VH-Lab/Microdrive-Array/SpikeGadgets_OpenEphys_Drive-main/README.md

# SpikeGadgets_OpenEphys_Drive
A tetrode hyper drive adapted from open ephys to work with spikegadgets
