VH-Lab/Microdrive-Array/Pictures.docx

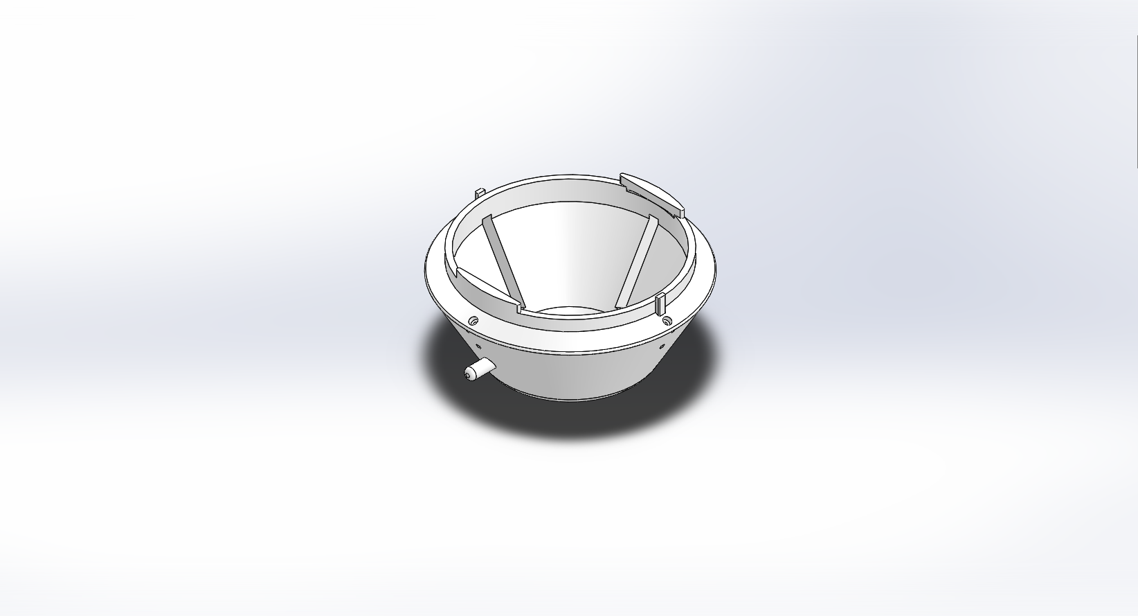
[picture p1: figure]
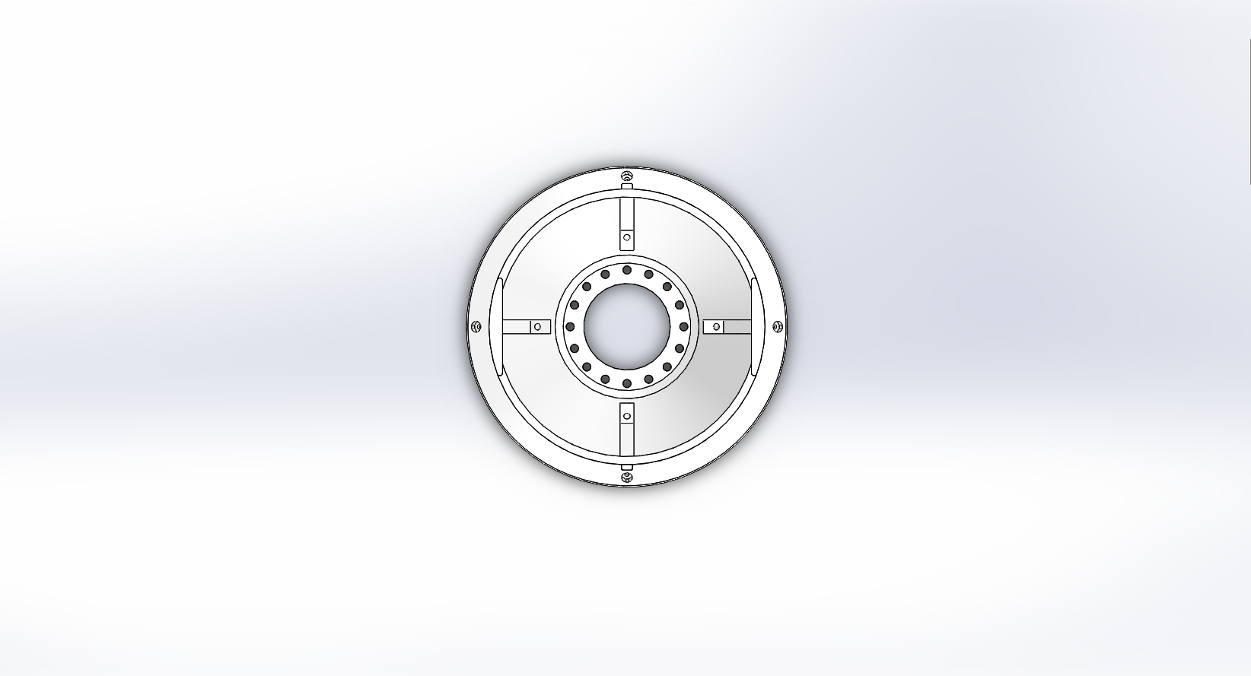
[picture p2: figure]
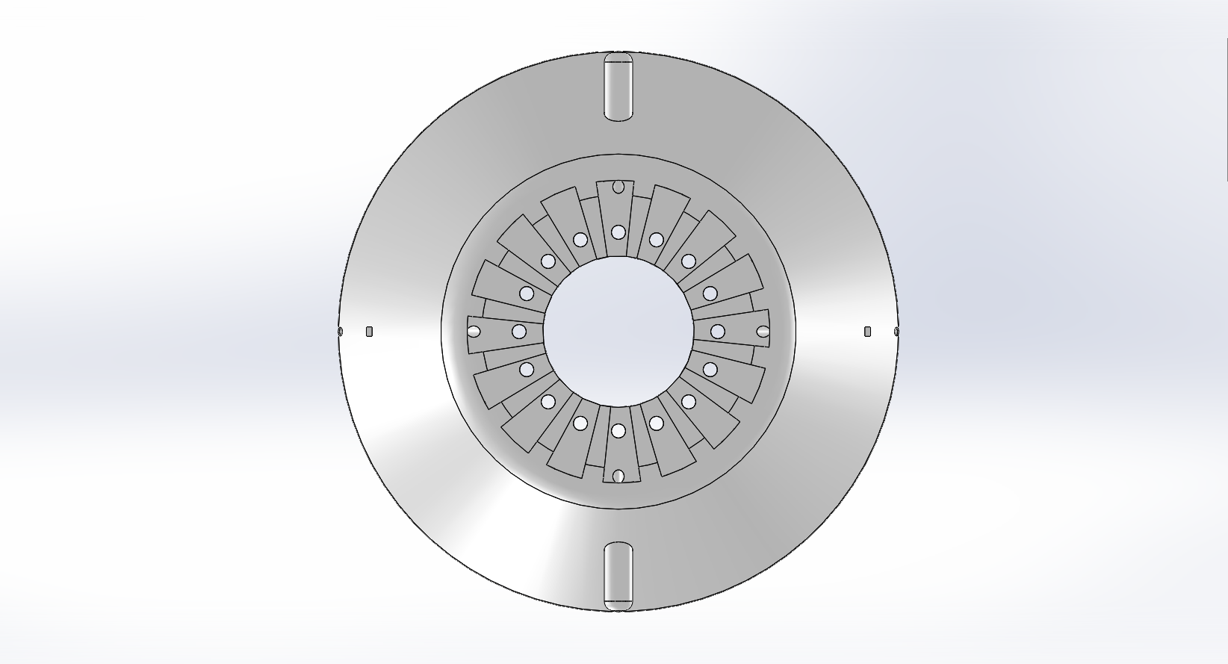
[picture p3: figure]
