VH-Lab/Microdrive-Array/SpikeGadgets_OpenEphys_Drive-main/Bill of Parts.xlsx

Sheet: Open Ephys Bill of Parts
Parts and components to the open ephys rat 64 drive |  | DIY fabrication
Assembly | Part |  | fabrication type/material | source |  | part # | lead time | unit price | n/unit | n/drive | batch price | notes
Drive Jig |  |  |  |  |  |  |  |  |  |  |  | IN STL folder
 | Jig Base | Formlabs TOUGH at 50-100 um layer height | lo res nylon .12mm z | Protolabs |  | STL |  |  |  | 1 |  | IN STL folder
 | Plating Jig | Formlabs TOUGH at 50-100 um layer height | lo res nylon .12mm z | protolabs |  | STL |  |  |  | 1 |  | IN STL folder
 | Drive holder outer | Formlabs TOUGH at 50-100 um layer height | med res nylon .03mm z | protolabs |  | STL |  |  |  | 1 |  | IN STL folder
 | drive holder inner | Formlabs TOUGH at 50-100 um layer height | med res nylon .03mm z | protolabs |  | STL |  |  |  | 1 |  | IN STL folder
 | EIB holder top | Formlabs TOUGH at 50-100 um layer height | med res nylon .03mm z | protolabs |  | STL |  |  |  | 1 |  | IN STL folder
 | EIB holder for 256 | Formlabs TOUGH at 50-100 um layer height | med res nylon .03mm z | protolabs |  | STL |  |  |  | 1 |  | IN STL folder
 |  | ** when using tough, be sure to cure correctly
 | 6mm dowel pin, 80mm long | check dowel diameter… this may be for mouse | Steel | mcmaster carr | https://www.mcmaster.com/91595A490/ | 91585A743 (https://www.mcmaster.com/91585A743) |  | 10.58 | 7 | 2 | 10.58 | https://www.mcmaster.com/91595a113 | WE HAVE EXTRAS
 | Head Screw for EIB-Drive distance |  | steel | mcmaster carr |  | 91290A201 (https://www.mcmaster.com/91290A201) |  | 4.8 | 10 | 1 | 3.28 | https://www.mcmaster.com/91292a024 | WE HAVE EXTRAS
 | 1/2" Thick Lead Disc, 2-3/4" OD, 13/32" ID | actually really helpful | lead | mcmaster carr |  | 90385K22 |  | 18.98 | 10 | 1 | 18.98 | https://www.mcmaster.com/90385k22 | not too necessary
 | M2 screws (for clamping base & EIB holder) |  | 2 | mcmaster carr |  | 91292A337 (https://www.mcmaster.com/91292A337) |  | 14.44 | 10 | 2 | 14.44 | various, check length
 | M2 nuts (for clamping base & Eib holder) |  | 2 | mcmaster carr |  | 90592A075 |  | 1.59 | 100 | 2 | 1.59 | https://www.mcmaster.com/90592a075
64 shuttle drive |  |  |  |  |  |  |  |  |  |  | for ten drives:
 | Tetrode guide bottom | formlabs clear at 50 um layer height
 | Drive body | formlabs clear at 50 um | 3d Systems Accura 60 SLA 0.0508 z, 0.1016 xy | Usually Protolabs |  | STL |  | 100 |  |  | ~1000 | in STL folder, Also can use Somos WaterShed XC 11122 | *** ORIENT WITH DRIVE UPSIDE DOWN< NOT DIAGONAL
 | Shuttles (18/pallet) | formlabs grey pro or black, or tough | Microfine green, 0.0254 layer 0.0508 xy | protolabs |  | STL |  | 30 | 36 | 2 | ~400 | IN STL folder
 | Screws |  | 404 stainless | Antrin |  | rat_shuttle_drive_custom_screw-slanted' | 7 weeks | ~3.5 | 1000 | 64 | ~3500 | Long lead time, probably the most expensive/crucial part to these drives
 | Polymicro tubing, 2cm lengths |  | *** PROBABLY NEED MORE THAN 2CM | Molex |  | TSP100170 |  | 247 | 20x10m | <1m | 247 | Amazon is way better, get like 100 ft | WM19371-ND | 1068150020 | https://www.mouser.com/ProductDetail/Molex/106815-0020
 | Polyimide tubing 30 GA |  | polyimide, usually a reel, or long cuts | Minvasive components |  | 72113300022-012 | ** microlumen is way cheaper, and more consistent |  |  |  |  | Microlumen polymide tubing ID:0.0070 OD:0.0083 wall:0.00065 |  | 68- 0.50
 | gold pins (small) |  | gold | neuralynx etc. |  | N/A |  |  | tons
 | 256 tetrode EIB |  | 4 layered PCB, gold plating and solder masks | JLC PCB |  |  |  |  |  | 1 | ~5 | Super Cheap at JLC PCB website
 | EIB mating board for SpikeGadgets |  | or buy spikegadgets 256 channel eibs
 | * buy a NanoZ from WhiteMatter LLC. The adapters are in github
Random Consumables
 | Mobil polyrex EM or similar |  | 0 | amazon or similar |  | N/A |  |  |  |  |  | for use as a lubricant, definitely not essential
 | 5 min epoxy |  | 0.01 | amazon or similar |  | N/A |  |  |  |  |  | the cheap stuff
 | Tetric EvoFlow Flowable Composite Restorative – 2 g Syringe Refill Shade Transparent |  | 0.33 | Ivoclar Vivadent, dental suppliers |  | 717-2380 |  |  |  |  |  | high flow composite, useful for gluing in hard-to-reach places
 | TotalGround or SuperShield or conductive epoxy |  | 0.01 | amazon or similar |  | mg chemicals 838AR-340G or 841AR-150ML |  |  |  |  |  | Conductive paint for the outside of the drive
 | Flow-It ALC uv curing cement |  | actually, this isnt very useful | safcodental |  | 573-1001 |  |  | 6x1.5g | 1 | 101.95 | https://www.safcodental.com/catalog/cosmetic-dentistry-filling-materials/composite-filling-materials-flowable/flow-it-alc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
 |  |  | mm to mil conversion
 |  |  | mm | thousandths |  |  | mm | thousandths
 |  |  | 1 | 39.3701 |  |  | 1.259128683 | 50
 |  |  | 0.5 | 19.68505 |  |  | 0.6295643415 | 25
 |  |  | 0.25 | 9.842525 |  |  | 0.3147821707 | 12.5
 |  |  | 0.125 | 4.9212625 |  |  | 0.1573910854 | 6.25
 |  |  | 0.1 | 3.93701 |  |  | 0.1259128683 | 5
 |  |  | 0.05 | 1.968505 |  |  | 0.1007302946 | 4
 |  |  | 0.025 | 0.9842525 |  |  | 0.07554772098 | 3
 |  |  | 0.0125 | 0.49212625 |  |  | 0.05036514732 | 2
 |  |  |  |  |  |  | 0.02518257366 | 1
 |  |  |  |  |  |  | 0.006295643415 | 0.25
 |  |  |  |  |  |  | 0.003147821707 | 0.125
 |  |  |  |  |  |  | 0.002518257366 | 0.1
 |  |  |  |  |  |  | 0.001259128683 | 0.05

Sheet: Jig Assembly notes
Assembly jigs:
The jigs are made up of various 3d-printed components, and a few screws and dowels.
Some components can be printed with relatively low-resolution processes (ideally sintered nylon powder at !0.12mm layer height, but high quality fused plastic could also work), while some required medium-resolution printing (Multijet Modeling or Stereolithography, with around 0.03mm layer thickness).
 | For example, the low quality parts can be printed with the Shapeways versatile plastic process, while the medium quality parts can be printed with smooth fine detail plastic.
 | The components are:
 | 1 -Base (low quality) - the base everything else sits on. Shared bwteeen the rat and the mouse design. All other componets differ between the two variants.
 | 2 -Outer drive holder (medium quality*) - connects to the base and holds the drive holder.
 | 3 -Inner drive holder (medium quality*) - sits inside the outer drive holder and directly holds the drive body, allowing it to rotate around its major axis.
 | 4 -Inner EIB holder (medium quality*) - holds the EIB, allowing it to rotate. This part may have to be customized to fit the desired type of EIB.
 | 5 -Outer EIB holder (medium quality*) - Holds the inner EIB holder.
 | 6- Manual adjustment knob (low quality) to make adjusting the long screw easier - hand-adjustible screws can be used alternatively, or tools can be used ot adjust mechnaism distance.
Assembling the assembly jigs:
 | - Glue lead disc into base with epoxy, and cover entire base surface with epoxy, so that no lead remains exposed.
 | - The dowels should slide freely trough the lower side of the slide / trough the outher drive holder, and the adjustment screw should freely slide trough the hold in the outer EIB holder. If not, these holes can be drilled out.
 | - If needed, the dowels can be glued into one side of the linear slide by using the provided glue pockets, and similarly, threads for the adjustment screw can be formed by lightly oiling the screw, turning it trough the lower part of the slide (the outer drive holder) and the filling the provided cavity with epoxy.
 | - Insert lower EIB holder into the base, and add clamping screw and nut.
 | - (For the mouse variant) insert inner EIB holder into outer EIB holder and add clamping screw and nut.
 | - Glue clamping nuts to the 3d printed parts with epoxy in their clamped state.
 | - Insert slide with EIB holder into the outer drive holder and verify proper function of the distance adjustment.

Sheet: HD shuttle drive components
 | Jakob Voigts, Jonathan P. Newman, Matthew A. Wilson, Mark T. Harnett |  |  | An easy-to-assemble, robust, and light drive implant for chronic tetrode recordings in freely moving animals
 |  |  |  | see manuscript: https://www.biorxiv.org/content/10.1101/746651v1
 |  |  |  | and github repository: https://github.com/open-ephys/shuttle-drive
Many of these prices are approximations |  | Component | N/drive | Supplier | Part Nr / source files |  | notes
Consumables: |  |  |  |  |  |  |  | Additional supplier | PN | Manufacturer PN
 | Drive mechanism | Drive body | 1 | Protolabs | see github
 |  | Shuttles (18/palette) | 1 | Protolabs | see github
 |  | Screws | 16 | Antrin miniature screws | see github |  | reusable a few times if careful
 |  | Polymicro tubing, 2cm lengths | 16 | Molex | TSP100170 |  |  | DigiKey | WM19371-ND | 1068150020
 | Guide tube array | Polymide tubing, 30GA, length depends | 16 | Minvasive components | 72113300022-012 |  |  | Microlumen polymide tubing ID:0.0070 OD:0.0083 wall:0.00065 |  | 68- 0.50
 | EIB | PCBs | 1 | seeedstudio | see github
 |  | connectors | 2 | omnetics (NPD-36-VV-GS) or hirose DF40GB(3.0)-70DS-0.4V(58) | see github
 |  | gold pins (small) | 64 | neuralynx etc. | N/A |  | can these be re-used?
 |  | tetrode wire, nichrome , ~12um | 16 | kanthal etc | N/A |  |  | Amazon | search 'tetrode wire' | n/a
 | Glues/lubricants | Mobil polyrex EM or similar | 0 | amazon or similar | N/A
 |  | 5 min epoxy | 0.01 | amazon or similar | N/A
 |  | Tetric EvoFlow Flowable Composite Restorative – 2 g Syringe Refill Shade Transparent | 0.33 | Ivoclar Vivadent, dental suppliers | 717-2380
 |  | TotalGround or SuperShield or conductive epoxy | 0.01 | amazon or similar | mg chemicals 838AR-340G or 841AR-150ML
Needed per assembly station | Tools | Stereo microscope & illumination | 1 |  | N/A | 500-1000
 |  | #3 forceps (assembling plastic parts) | 1 | Fine Science tools | N/A | 80
 |  | sewing needle for widening polymide ends | 1 | N/A | N/A | 1
 |  | Ceramic tipped forceps (handling tetrodes) | 1 | Fine Science tools | N/A | 100
 |  | Polymicro cutting tool (ceramic tile or sapphire knife) | 1 | N/A | N/A | 10
 |  | Custom screwdriver for drive screws | 1 | N/A | N/A | ~100 assembled?
 |  | Blue curing light | 1 | amazon or similar | N/A | 15
 |  | Soldering equipment for EIB | 1 | amazon or similar | N/A | 100-500
 | Assembly jig | 3mm dowel pin, 40mm long | 2 | mcmaster carr | 91595A142
 |  | M3 screw, 40mm long | 1 | mcmaster carr | 91292A024
 |  | 1/2" Thick Lead Disc, 2-3/4" OD, 13/32" ID | 1 | mcmaster carr | 90385K22
 |  | M2 screws (for clamping base) | 2 | mcmaster carr | ?
 |  | M2 nuts (for clamping base) | 2 | mcmaster carr | ?
 |  | Jig base | 1 | protolabs low q (strong white) | see github
 |  | Drive body holder outer | 1 | protolabs high q (high precision transparent) | see github
 |  | Drive body holder inner | 1 | protolabs high q (high precision transparent) | see github
 |  | Eib holder inner | 1 | protolabs high q (high precision transparent) | see github
 |  | Eib holder outer | 1 | protolabs high q (high precision transparent) | see github

Sheet: OE and SG pin maps
Non-inverted pin maps
As appears on Open Ephys EIB
Headers on: |  |  | 2x35+4_DF40-70HEAD (pinhd-2X35+4)
header | Pin # | Tetrode Pin | Header | Pin # | Tetrode pin | header | Pin # | Tetrode Pin | Header | Pin # | Tetrode pin | header | Pin # | Tetrode Pin | Header | Pin # | Tetrode pin | header | Pin # | Tetrode Pin | Header | Pin # | Tetrode pin
struct | XX | GND | struct | XX | GND | struct | xx | GND | struct | xx | GND | struct | xx | GND | struct | xx | GND | struct | xx | GND | struct | xx | GND
J1_1 | GND? | REF_A | J1_70 | 70 | GND | J2_1 | 71 | REF_C | J2_70 | 140 | GND | J3_1 | 141 | REF_B | J3_70 | 210 | GND | J4_1 | 211 | AUXIN2_A | J4_70 | 280 | GND
J1_2 | 1 | 'T01_W01' | J1_69 | 69 | ESTIM_A | J2_2 | 72 | 'T17_W01' | J2_69 | 139 | AUXIN1_C | J3_2 | 142 | 'T33_W01' | J3_69 | 209 | ESTIM_B | J4_2 | 212 | 'T49_W01' | J4_69 | 279 | AUXIN1_A
J1_3 | 2 | 'T01_W02' | J1_68 | 68 | 'T16_W04' | J2_3 | 73 | 'T17_W02' | J2_68 | 138 | 'T32_W04' | J3_3 | 143 | 'T33_W02' | J3_68 | 208 | 'T48_W04' | J4_3 | 213 | 'T49_W02' | J4_68 | 278 | 'T64_W04'
J1_4 | 3 | 'T01_W03' | J1_67 | 67 | 'T16_W03' | J2_4 | 74 | 'T17_W03' | J2_67 | 137 | 'T32_W03' | J3_4 | 144 | 'T33_W03' | J3_67 | 207 | 'T48_W03' | J4_4 | 214 | 'T49_W03' | J4_67 | 277 | 'T64_W03'
J1_5 | 4 | 'T01_W04' | J1_66 | 66 | 'T16_W02' | J2_5 | 75 | 'T17_W04' | J2_66 | 136 | 'T32_W02' | J3_5 | 145 | 'T33_W04' | J3_66 | 206 | 'T48_W02' | J4_5 | 215 | 'T49_W04' | J4_66 | 276 | 'T64_W02'
J1_6 | 5 | 'T02_W01' | J1_65 | 65 | 'T16_W01' | J2_6 | 76 | 'T18_W01' | J2_65 | 135 | 'T32_W01' | J3_6 | 146 | 'T34_W01' | J3_65 | 205 | 'T48_W01' | J4_6 | 216 | 'T50_W01' | J4_65 | 275 | 'T64_W01'
J1_7 | 6 | 'T02_W02' | J1_64 | 64 | 'T15_W04' | J2_7 | 77 | 'T18_W02' | J2_64 | 134 | 'T31_W04' | J3_7 | 147 | 'T34_W02' | J3_64 | 204 | 'T47_W04' | J4_7 | 217 | 'T50_W02' | J4_64 | 274 | 'T63_W04'
J1_8 | 7 | 'T02_W03' | J1_63 | 63 | 'T15_W03' | J2_8 | 78 | 'T18_W03' | J2_63 | 133 | 'T31_W03' | J3_8 | 148 | 'T34_W03' | J3_63 | 203 | 'T47_W03' | J4_8 | 218 | 'T50_W03' | J4_63 | 273 | 'T63_W03'
J1_9 | 8 | 'T02_W04' | J1_62 | 62 | 'T15_W02' | J2_9 | 79 | 'T18_W04' | J2_62 | 132 | 'T31_W02' | J3_9 | 149 | 'T34_W04' | J3_62 | 202 | 'T47_W02' | J4_9 | 219 | 'T50_W04' | J4_62 | 272 | 'T63_W02'
J1_10 | 9 | 'T03_W01' | J1_61 | 61 | 'T15_W01' | J2_10 | 80 | 'T19_W01' | J2_61 | 131 | 'T31_W01' | J3_10 | 150 | 'T35_W01' | J3_61 | 201 | 'T47_W01' | J4_10 | 220 | 'T51_W01' | J4_61 | 271 | 'T63_W01'
J1_11 | 10 | 'T03_W02' | J1_60 | 60 | 'T14_W04' | J2_11 | 81 | 'T19_W02' | J2_60 | 130 | 'T30_W04' | J3_11 | 151 | 'T35_W02' | J3_60 | 200 | 'T46_W04' | J4_11 | 221 | 'T51_W02' | J4_60 | 270 | 'T62_W04'
J1_12 | 11 | 'T03_W03' | J1_59 | 59 | 'T14_W03' | J2_12 | 82 | 'T19_W03' | J2_59 | 129 | 'T30_W03' | J3_12 | 152 | 'T35_W03' | J3_59 | 199 | 'T46_W03' | J4_12 | 222 | 'T51_W03' | J4_59 | 269 | 'T62_W03'
J1_13 | 12 | 'T03_W04' | J1_58 | 58 | 'T14_W02' | J2_13 | 83 | 'T19_W04' | J2_58 | 128 | 'T30_W02' | J3_13 | 153 | 'T35_W04' | J3_58 | 198 | 'T46_W02' | J4_13 | 223 | 'T51_W04' | J4_58 | 268 | 'T62_W02'
J1_14 | 13 | 'T04_W01' | J1_57 | 57 | 'T14_W01' | J2_14 | 84 | 'T20_W01' | J2_57 | 127 | 'T30_W01' | J3_14 | 154 | 'T36_W01' | J3_57 | 197 | 'T46_W01' | J4_14 | 224 | 'T52_W01' | J4_57 | 267 | 'T62_W01'
J1_15 | 14 | 'T04_W02' | J1_56 | 56 | 'T13_W04' | J2_15 | 85 | 'T20_W02' | J2_56 | 126 | 'T29_W04' | J3_15 | 155 | 'T36_W02' | J3_56 | 196 | 'T45_W04' | J4_15 | 225 | 'T52_W02' | J4_56 | 266 | 'T61_W04'
J1_16 | 15 | 'T04_W03' | J1_55 | 55 | 'T13_W03' | J2_16 | 86 | 'T20_W03' | J2_55 | 125 | 'T29_W03' | J3_16 | 156 | 'T36_W03' | J3_55 | 195 | 'T45_W03' | J4_16 | 226 | 'T52_W03' | J4_55 | 265 | 'T61_W03'
J1_17 | 16 | 'T04_W04' | J1_54 | 54 | 'T13_W02' | J2_17 | 87 | 'T20_W04' | J2_54 | 124 | 'T29_W02' | J3_17 | 157 | 'T36_W04' | J3_54 | 194 | 'T45_W02' | J4_17 | 227 | 'T52_W04' | J4_54 | 264 | 'T61_W02'
J1_18 | 17 | 'T05_W01' | J1_53 | 53 | 'T13_W01' | J2_18 | 88 | 'T21_W01' | J2_53 | 123 | 'T29_W01' | J3_18 | 158 | 'T37_W01' | J3_53 | 193 | 'T45_W01' | J4_18 | 228 | 'T53_W01' | J4_53 | 263 | 'T61_W01'
J1_19 | 18 | 'T05_W02' | J1_52 | 52 | 'T12_W04' | J2_19 | 89 | 'T21_W02' | J2_52 | 122 | 'T28_W04' | J3_19 | 159 | 'T37_W02' | J3_52 | 192 | 'T44_W04' | J4_19 | 229 | 'T53_W02' | J4_52 | 262 | 'T60_W04'
J1_20 | 19 | 'T05_W03' | J1_51 | 51 | 'T12_W03' | J2_20 | 90 | 'T21_W03' | J2_51 | 121 | 'T28_W03' | J3_20 | 160 | 'T37_W03' | J3_51 | 191 | 'T44_W03' | J4_20 | 230 | 'T53_W03' | J4_51 | 261 | 'T60_W03'
J1_21 | 20 | 'T05_W04' | J1_50 | 50 | 'T12_W02' | J2_21 | 91 | 'T21_W04' | J2_50 | 120 | 'T28_W02' | J3_21 | 161 | 'T37_W04' | J3_50 | 190 | 'T44_W02' | J4_21 | 231 | 'T53_W04' | J4_50 | 260 | 'T60_W02'
J1_22 | 21 | 'T06_W01' | J1_49 | 49 | 'T12_W01' | J2_22 | 92 | 'T22_W01' | J2_49 | 119 | 'T28_W01' | J3_22 | 162 | 'T38_W01' | J3_49 | 189 | 'T44_W01' | J4_22 | 232 | 'T54_W01' | J4_49 | 259 | 'T60_W01'
J1_23 | 22 | 'T06_W02' | J1_48 | 48 | 'T11_W04' | J2_23 | 93 | 'T22_W02' | J2_48 | 118 | 'T27_W04' | J3_23 | 163 | 'T38_W02' | J3_48 | 188 | 'T43_W04' | J4_23 | 233 | 'T54_W02' | J4_48 | 258 | 'T59_W04'
J1_24 | 23 | 'T06_W03' | J1_47 | 47 | 'T11_W03' | J2_24 | 94 | 'T22_W03' | J2_47 | 117 | 'T27_W03' | J3_24 | 164 | 'T38_W03' | J3_47 | 187 | 'T43_W03' | J4_24 | 234 | 'T54_W03' | J4_47 | 257 | 'T59_W03'
J1_25 | 24 | 'T06_W04' | J1_46 | 46 | 'T11_W02' | J2_25 | 95 | 'T22_W04' | J2_46 | 116 | 'T27_W02' | J3_25 | 165 | 'T38_W04' | J3_46 | 186 | 'T43_W02' | J4_25 | 235 | 'T54_W04' | J4_46 | 256 | 'T59_W02'
J1_26 | 25 | 'T07_W01' | J1_45 | 45 | 'T11_W01' | J2_26 | 96 | 'T23_W01' | J2_45 | 115 | 'T27_W01' | J3_26 | 166 | 'T39_W01' | J3_45 | 185 | 'T43_W01' | J4_26 | 236 | 'T55_W01' | J4_45 | 255 | 'T59_W01'
J1_27 | 26 | 'T07_W02' | J1_44 | 44 | 'T10_W04' | J2_27 | 97 | 'T23_W02' | J2_44 | 114 | 'T26_W04' | J3_27 | 167 | 'T39_W02' | J3_44 | 184 | 'T42_W04' | J4_27 | 237 | 'T55_W02' | J4_44 | 254 | 'T58_W04'
J1_28 | 27 | 'T07_W03' | J1_43 | 43 | 'T10_W03' | J2_28 | 98 | 'T23_W03' | J2_43 | 113 | 'T26_W03' | J3_28 | 168 | 'T39_W03' | J3_43 | 183 | 'T42_W03' | J4_28 | 238 | 'T55_W03' | J4_43 | 253 | 'T58_W03'
J1_29 | 28 | 'T07_W04' | J1_42 | 42 | 'T10_W02' | J2_29 | 99 | 'T23_W04' | J2_42 | 112 | 'T26_W02' | J3_29 | 169 | 'T39_W04' | J3_42 | 182 | 'T42_W02' | J4_29 | 239 | 'T55_W04' | J4_42 | 252 | 'T58_W02'
J1_30 | 29 | 'T08_W01' | J1_41 | 41 | 'T10_W01' | J2_30 | 100 | 'T24_W01' | J2_41 | 111 | 'T26_W01' | J3_30 | 170 | 'T40_W01' | J3_41 | 181 | 'T42_W01' | J4_30 | 240 | 'T56_W01' | J4_41 | 251 | 'T58_W01'
J1_31 | 30 | 'T08_W02' | J1_40 | 40 | 'T09_W04' | J2_31 | 101 | 'T24_W02' | J2_40 | 110 | 'T25_W04' | J3_31 | 171 | 'T40_W02' | J3_40 | 180 | 'T41_W04' | J4_31 | 241 | 'T56_W02' | J4_40 | 250 | 'T57_W04'
J1_32 | 31 | 'T08_W03' | J1_39 | 39 | 'T09_W03' | J2_32 | 102 | 'T24_W03' | J2_39 | 109 | 'T25_W03' | J3_32 | 172 | 'T40_W03' | J3_39 | 179 | 'T41_W03' | J4_32 | 242 | 'T56_W03' | J4_39 | 249 | 'T57_W03'
J1_33 | 32 | 'T08_W04' | J1_38 | 38 | 'T09_W02' | J2_33 | 103 | 'T24_W04' | J2_38 | 108 | 'T25_W02' | J3_33 | 173 | 'T40_W04' | J3_38 | 178 | 'T41_W02' | J4_33 | 243 | 'T56_W04' | J4_38 | 248 | 'T57_W02'
J1_34 | 34 | CAT0_A | J1_37 | 37 | 'T09_W01' | J2_34 | 104 | AUXIN1_B | J2_37 | 107 | 'T25_W01' | J3_34 | 174 | CAT0_B | J3_37 | 177 | 'T41_W01' | J4_34 | 244 | AUXIN1_D | J4_37 | 247 | 'T57_W01'
J1_35 | 35 | CAT1_A | J1_36 | 36 | AN_A | J2_35 | 105 | GND | J2_36 | 106 | AUXIN2_B | J3_35 | 175 | CAT1_B | J3_36 | 176 | AN_B | J4_35 | 245 | GND | J4_36 | 246 | REF_D
struct | XX | GND | struct | XX | GND | struct | xx | GND | struct | xx | GND | struct | xx | GND | struct | xx | GND | struct |  | GND | struct |  | GND
Notes: The pin map for these hiroses start at top left. This is correct and face up for the hirose heads.
To mate this, you will use the Hirose receiver which is inverse to this, and flip it so that it matches the above
OLD SpikeGadgets pin map |  |  |  |  |  |  |  | As appears on OE-SG IB
headers on |  |  | 2x35+4_DF40-70HEAD (pinhd-2X35+4) |  |  |  |  | Headers on: |  |  | PINHD-2x35_DF40REC (PINHD-2x35)
Header: | Pin # | Tetrode | Header: | Pin # | Tetrode | Header: | Pin # | Tetrode | Header: | Pin # | Tetrode | Header: | Pin # | Tetrode | Header: | Pin # | Tetrode | Header: | Pin # | Tetrode | Header: | Pin # | Tetrode
J1_1 | XX | GND | J1_70 | XX | GND | J2_1 | XX | GND | J2_70 | XX | GND | J3_1 | XX | GND | J3_70 | XX | GND | J4_1 | XX | GND | J4_70 | XX | GND
J1_2 | XX | GND | J1_69 | 0 | T42_W01 | J2_2 | XX | GND | J2_69 | 64 |  | J3_2 | XX | GND | J3_69 | 128 |  | J4_2 | XX | GND | J4_69 | 192
J1_3 | 1 |  | J1_68 | 2 | T42_W02 | J2_3 | 65 | 'T01_W01' | J2_68 | 66 |  | J3_3 | 129 |  | J3_68 | 130 |  | J4_3 | 193 |  | J4_68 | 194
J1_4 | 3 |  | J1_67 | 4 | T42_W03 | J2_4 | 67 | 'T01_W02' | J2_67 | 68 |  | J3_4 | 131 |  | J3_67 | 132 |  | J4_4 | 195 |  | J4_67 | 196
J1_5 | 5 |  | J1_66 | 6 | T42_W04 | J2_5 | 69 | 'T01_W03' | J2_66 | 70 |  | J3_5 | 133 |  | J3_66 | 134 |  | J4_5 | 197 |  | J4_66 | 198
J1_6 | 7 |  | J1_65 | 8 |  | J2_6 | 71 | 'T01_W04' | J2_65 | 72 |  | J3_6 | 135 |  | J3_65 | 136 |  | J4_6 | 199 |  | J4_65 | 200
J1_7 | 9 |  | J1_64 | 10 |  | J2_7 | 73 | 'T03_W01' | J2_64 | 74 |  | J3_7 | 137 |  | J3_64 | 138 |  | J4_7 | 201 |  | J4_64 | 202
J1_8 | 11 |  | J1_63 | 12 |  | J2_8 | 75 | 'T03_W02' | J2_63 | 76 |  | J3_8 | 139 |  | J3_63 | 140 |  | J4_8 | 203 |  | J4_63 | 204
J1_9 | 13 |  | J1_62 | 14 |  | J2_9 | 77 | 'T03_W03' | J2_62 | 78 |  | J3_9 | 141 |  | J3_62 | 142 |  | J4_9 | 205 |  | J4_62 | 206
J1_10 | 15 |  | J1_61 | 16 |  | J2_10 | 79 | 'T03_W04' | J2_61 | 80 |  | J3_10 | 143 |  | J3_61 | 144 |  | J4_10 | 207 |  | J4_61 | 208
J1_11 | 17 |  | J1_60 | 18 |  | J2_11 | 81 | 'T02_W01' | J2_60 | 82 |  | J3_11 | 145 |  | J3_60 | 146 |  | J4_11 | 209 |  | J4_60 | 210
J1_12 | 19 |  | J1_59 | 20 |  | J2_12 | 83 | 'T02_W02' | J2_59 | 84 |  | J3_12 | 147 |  | J3_59 | 148 |  | J4_12 | 211 |  | J4_59 | 212
J1_13 | 21 |  | J1_58 | 22 |  | J2_13 | 85 | 'T02_W03' | J2_58 | 86 |  | J3_13 | 149 |  | J3_58 | 150 |  | J4_13 | 213 |  | J4_58 | 214
J1_14 | 23 |  | J1_57 | 24 |  | J2_14 | 87 | 'T02_W04' | J2_57 | 88 |  | J3_14 | 151 |  | J3_57 | 152 |  | J4_14 | 215 |  | J4_57 | 216
J1_15 | 25 |  | J1_56 | 26 |  | J2_15 | 89 | 'T05_W01' | J2_56 | 90 |  | J3_15 | 153 |  | J3_56 | 154 |  | J4_15 | 217 |  | J4_56 | 218
J1_16 | 27 |  | J1_55 | 28 |  | J2_16 | 91 | 'T05_W02' | J2_55 | 92 |  | J3_16 | 155 |  | J3_55 | 156 |  | J4_16 | 219 |  | J4_55 | 220
J1_17 | 29 |  | J1_54 | 30 |  | J2_17 | 93 | 'T05_W03' | J2_54 | 94 |  | J3_17 | 157 |  | J3_54 | 158 |  | J4_17 | 221 |  | J4_54 | 222
J1_18 | 31 |  | J1_53 | 32 |  | J2_18 | 95 | 'T05_W04' | J2_53 | 96 |  | J3_18 | 159 |  | J3_53 | 160 |  | J4_18 | 223 |  | J4_53 | 224
J1_19 | 33 |  | J1_52 | 34 |  | J2_19 | 97 | 'T04_W01' | J2_52 | 98 |  | J3_19 | 161 |  | J3_52 | 162 |  | J4_19 | 225 |  | J4_52 | 226
J1_20 | 35 |  | J1_51 | 36 |  | J2_20 | 99 | 'T04_W02' | J2_51 | 100 |  | J3_20 | 163 |  | J3_51 | 164 |  | J4_20 | 227 |  | J4_51 | 228
J1_21 | 37 |  | J1_50 | 38 |  | J2_21 | 101 | 'T04_W03' | J2_50 | 102 |  | J3_21 | 165 |  | J3_50 | 166 |  | J4_21 | 229 |  | J4_50 | 230
J1_22 | 39 |  | J1_49 | 40 |  | J2_22 | 103 | 'T04_W04' | J2_49 | 104 |  | J3_22 | 167 |  | J3_49 | 168 |  | J4_22 | 231 |  | J4_49 | 232
J1_23 | 41 |  | J1_48 | 42 |  | J2_23 | 105 | 'T07_W01' | J2_48 | 106 |  | J3_23 | 169 |  | J3_48 | 170 |  | J4_23 | 233 |  | J4_48 | 234
J1_24 | 43 |  | J1_47 | 44 |  | J2_24 | 107 | 'T07_W02' | J2_47 | 108 |  | J3_24 | 171 |  | J3_47 | 172 |  | J4_24 | 235 |  | J4_47 | 236
J1_25 | 45 |  | J1_46 | 46 |  | J2_25 | 109 | 'T07_W03' | J2_46 | 110 |  | J3_25 | 173 |  | J3_46 | 174 |  | J4_25 | 237 |  | J4_46 | 238
J1_26 | 47 |  | J1_45 | 48 |  | J2_26 | 111 | 'T07_W04' | J2_45 | 112 | T59_W01 | J3_26 | 175 |  | J3_45 | 176 |  | J4_26 | 239 |  | J4_45 | 240
J1_27 | 49 |  | J1_44 | 50 |  | J2_27 | 113 | 'T06_W01' | J2_44 | 114 | T59_W02 | J3_27 | 177 |  | J3_44 | 178 |  | J4_27 | 241 |  | J4_44 | 242
J1_28 | 51 |  | J1_43 | 52 |  | J2_28 | 115 | 'T06_W02' | J2_43 | 116 | T59_W03 | J3_28 | 179 |  | J3_43 | 180 |  | J4_28 | 243 |  | J4_43 | 244
J1_29 | 53 |  | J1_42 | 54 |  | J2_29 | 117 | 'T06_W03' | J2_42 | 118 | T59_W04 | J3_29 | 181 |  | J3_42 | 182 |  | J4_29 | 245 |  | J4_42 | 246
J1_30 | 55 |  | J1_41 | 56 |  | J2_30 | 119 | 'T06_W04' | J2_41 | 120 | 'T08_W01' | J3_30 | 183 |  | J3_41 | 184 |  | J4_30 | 247 |  | J4_41 | 248
J1_31 | 57 |  | J1_40 | 58 |  | J2_31 | 121 | T09_W01' | J2_40 | 122 | 'T08_W02' | J3_31 | 185 |  | J3_40 | 186 |  | J4_31 | 249 |  | J4_40 | 250
J1_32 | 59 |  | J1_39 | 60 |  | J2_32 | 123 | T09_W02' | J2_39 | 124 | 'T08_W03' | J3_32 | 187 |  | J3_39 | 188 |  | J4_32 | 251 |  | J4_39 | 252
J1_33 | 61 |  | J1_38 | 62 |  | J2_33 | 125 | T09_W03' | J2_38 | 126 | 'T08_W04' | J3_33 | 189 |  | J3_38 | 190 |  | J4_33 | 253 |  | J4_38 | 254
J1_34 | 63 |  | J1_37 | XX | GND | J2_34 | 127 | T09_W04' | J2_37 | XX | GND | J3_34 | 191 |  | J3_37 | XX | GND | J4_34 | 255 |  | J4_37 | XX | GND
J1_35 | XX | GND | J1_36 | XX | GND | J2_35 | XX | GND | J2_36 | XX | GND | J3_35 | XX | GND | J3_36 | XX | GND | J4_35 | XX | GND | J4_36 | XX | GND
Notes: They used a really messed up pin counting map, here it zig-zags and the first used pin is actually top right.
To map this, use this mapping scheme (or make your own and make sure you recognize the cris-cross they do) on any pin map.
Basically you will be using the heads for this, and they will be right-side up. This is literally the same for the OE-SG IB
