VH-Lab/Microdrive-Array/AssemblyV3.SLDASM

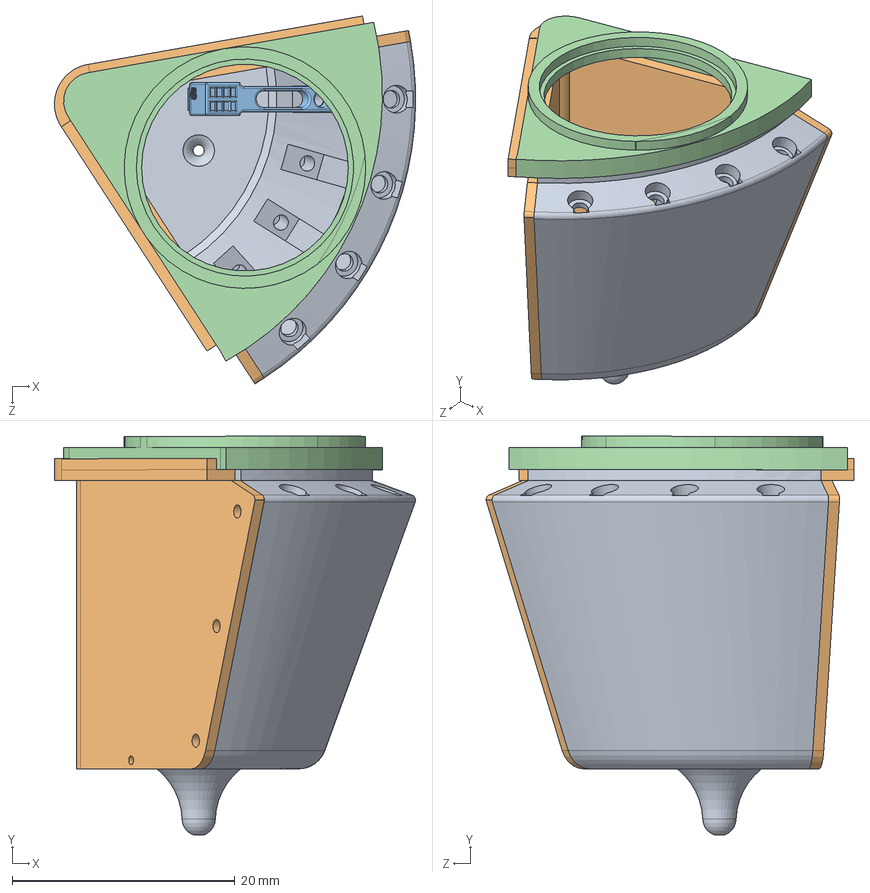
[picture p4: CAD file, 2022-04-26]
AssemblyV3.SLDASM
32.4 x 35.8 x 33.1 mm
Carbon Fiber Drive V3
Shuttle V3 .748
