VH-Lab/Microdrive-Array/Realize Shuttle Print/JIgV4Print.SLDASM

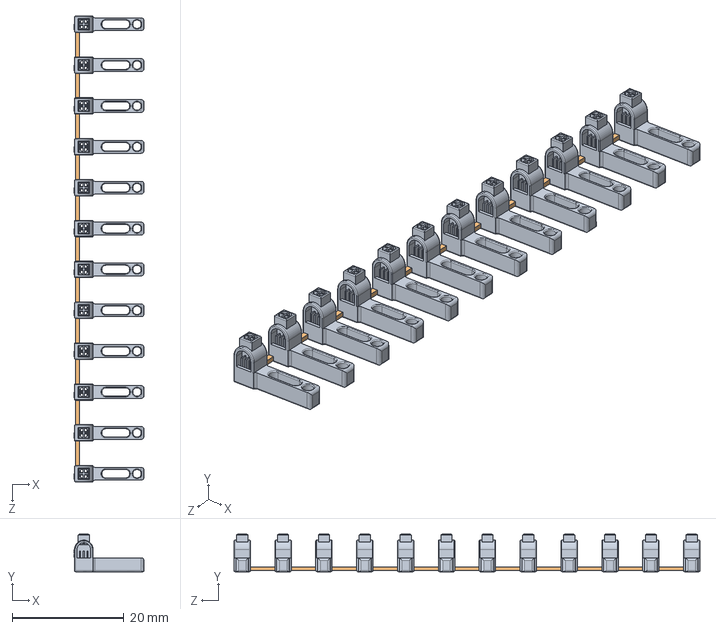
[picture p5: CAD file, 2022-03-24]
Realize Shuttle Print/JIgV4Print.SLDASM
12.5 x 6.70 x 83.2 mm
Shuttle V3 .748 x 12
Part3^JIgV4Print x 11
