VH-Lab/Microdrive-Array/Shuttle V3 print.SLDASM

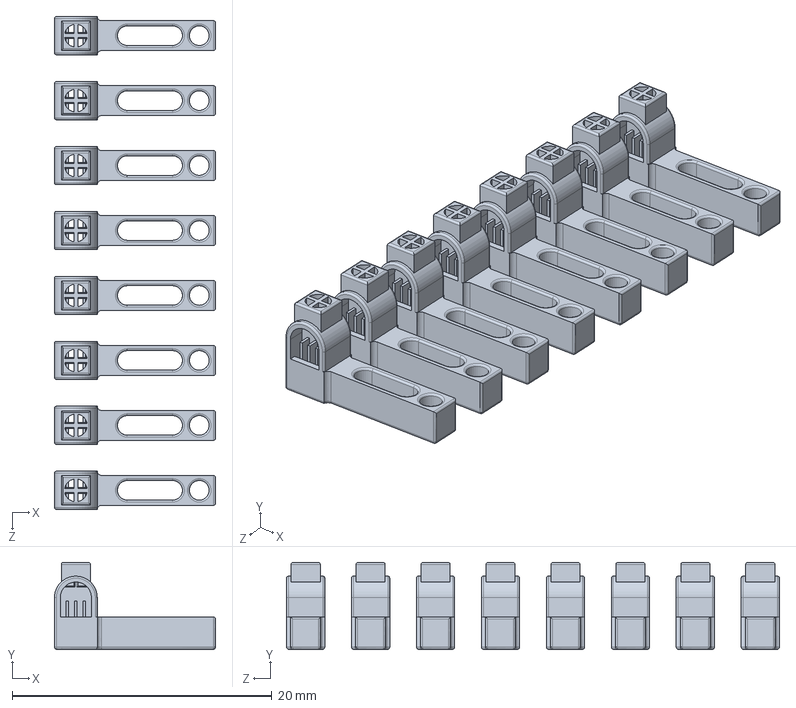
[picture p6: CAD file, 2022-03-24]
Shuttle V3 print.SLDASM
12.4 x 6.70 x 38.0 mm
Shuttle V3 x 8
