VH-Lab/Microdrive-Array/Shuttle v3 print2.SLDASM

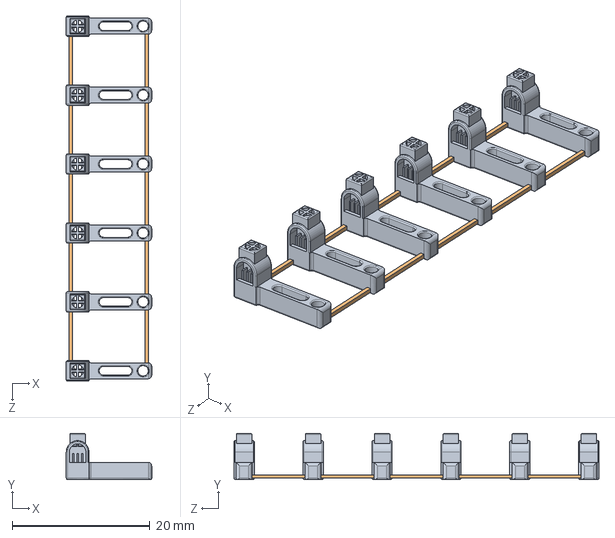
[picture p7: CAD file, 2022-03-24]
Shuttle v3 print2.SLDASM
12.4 x 6.70 x 53.0 mm
Shuttle V3 x 6
Part2^Shuttle v3 print2 x 5
