VH-Lab/Microdrive-Array/electrode jig pallet.SLDASM

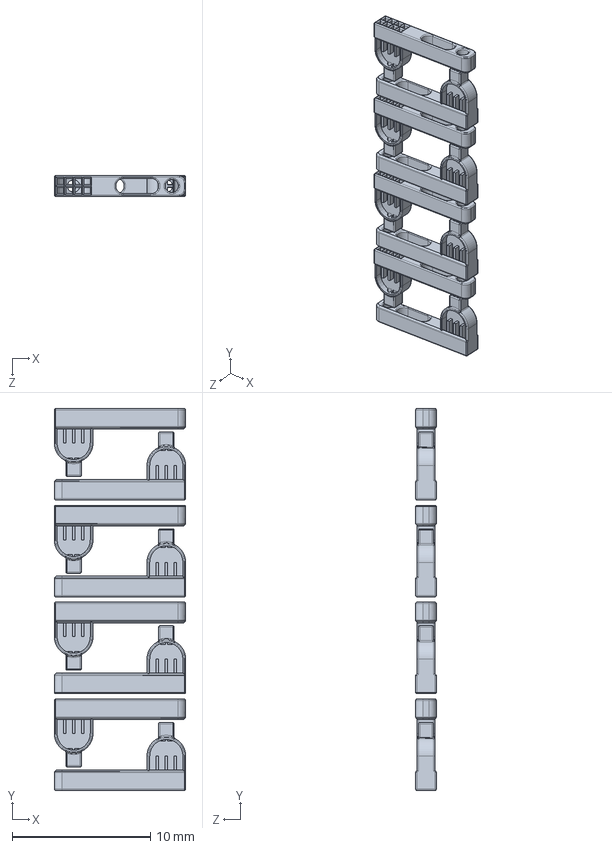
[picture p8: CAD file, 2022-03-24]
electrode jig pallet.SLDASM
9.50 x 27.6 x 1.50 mm
Drive_shuttle_jig x 8
