VH-Lab/Microdrive-Array/Assembly Carbon Fiber v1.SLDASM

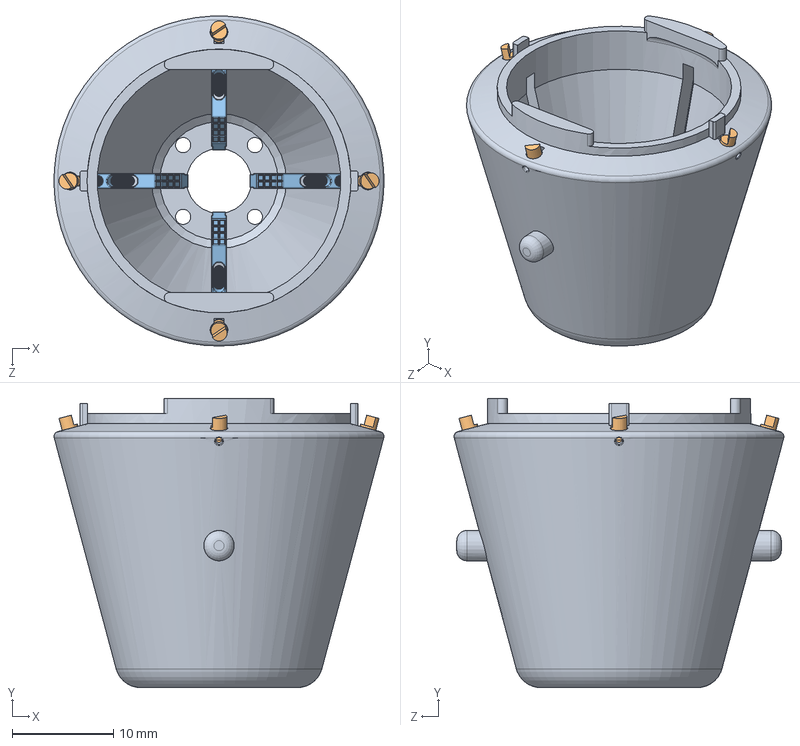
[picture p9: CAD file, 2022-03-24]
Assembly Carbon Fiber v1.SLDASM
32.5 x 28.5 x 32.5 mm
Carbon Fiber Drive V1
Slanted-threaded-sholder screw x 4
Drive_shuttle_jig x 4
