VH-Lab/Microdrive-Array/Assembly Jig.SLDASM

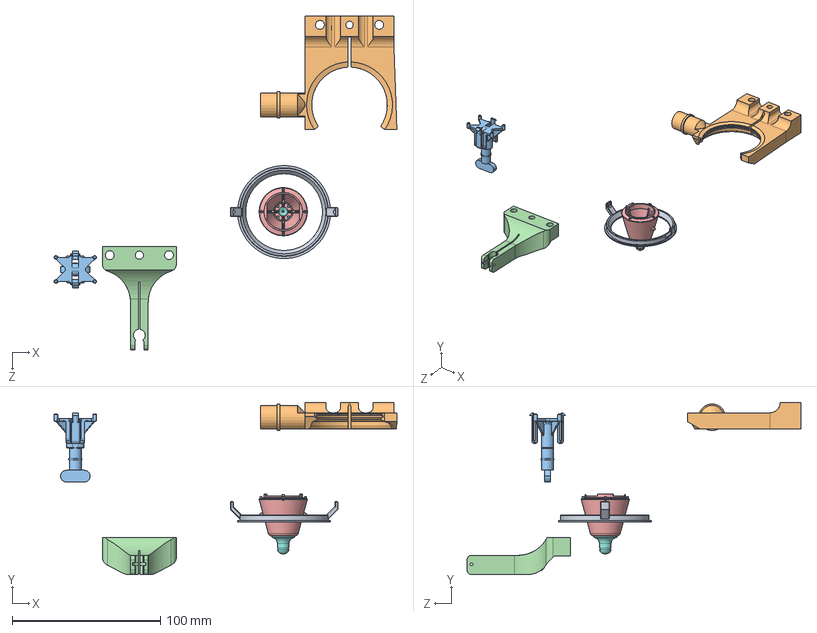
[picture p10: CAD file, 2022-03-24]
Assembly Jig.SLDASM
231.4 x 116.2 x 225.4 mm
drive_holder_inner
drive_holder_outer_ring
EIB_Holder_bottom
eib_holder_top
Carbon Fiber Drive V1
Slanted-threaded-sholder screw x 4
Drive_shuttle_jig x 4
drive-guide-HPC-PFC_v2.1
