VH-Lab/Microdrive-Array/Alex/rat_drive_shuttle_short_copy.SLDPRT

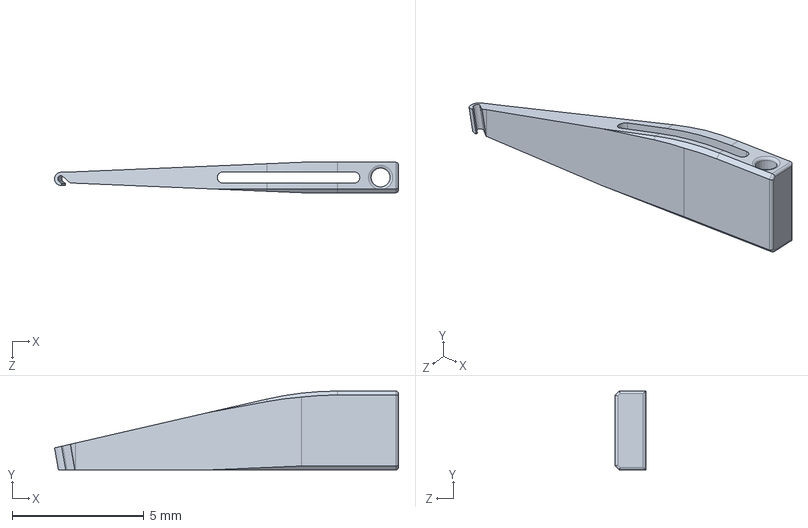
[picture p11: CAD file, 2022-03-24]
Alex/rat_drive_shuttle_short_copy.SLDPRT
13.1 x 3.00 x 1.16 mm
