VH-Lab/Microdrive-Array/Gianna/Shuttle V3 .748.STL

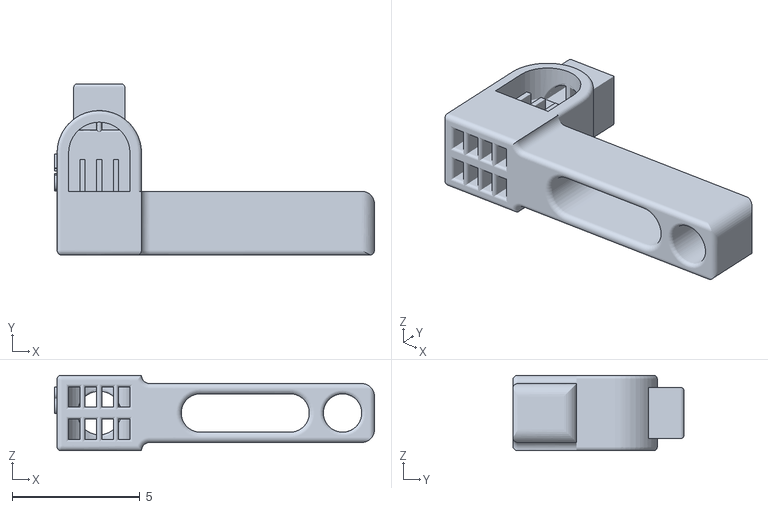
[picture p12: CAD file, 2022-03-24]
Gianna/Shuttle V3 .748.STL
12.5 x 6.70 x 2.95
