VH-Lab/Microdrive-Array/SpikeGadgets_OpenEphys_Drive-main/SG_Drive_Jig_Assembly/Drive/Drive_body_v4.SLDPRT

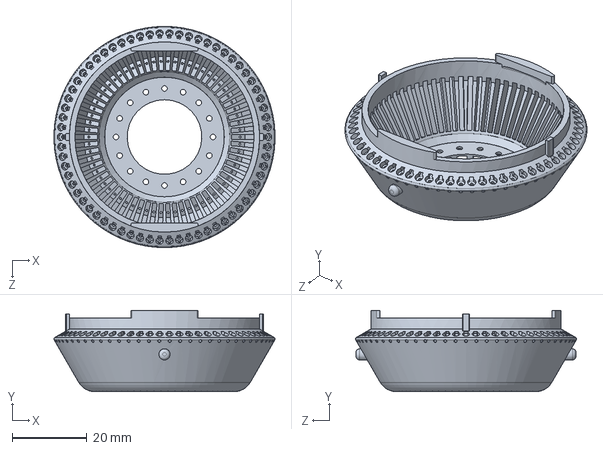
[picture p13: CAD file, 2022-03-24]
SpikeGadgets_OpenEphys_Drive-main/SG_Drive_Jig_Assembly/Drive/Drive_body_v4.SLDPRT
59.2 x 21.8 x 59.3 mm
