VH-Lab/Microdrive-Array/SpikeGadgets_OpenEphys_Drive-main/SG_Drive_Jig_Assembly/Jig/2020_12_14_stls/base.STL

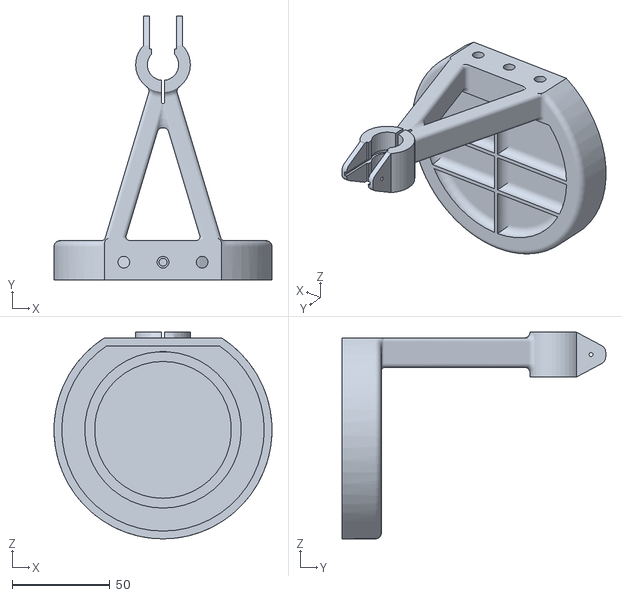
[picture p14: CAD file, 2022-03-24]
SpikeGadgets_OpenEphys_Drive-main/SG_Drive_Jig_Assembly/Jig/2020_12_14_stls/base.STL
111.5 x 134.8 x 105.8
