VH-Lab/Microdrive-Array/CoverV3.SLDPRT

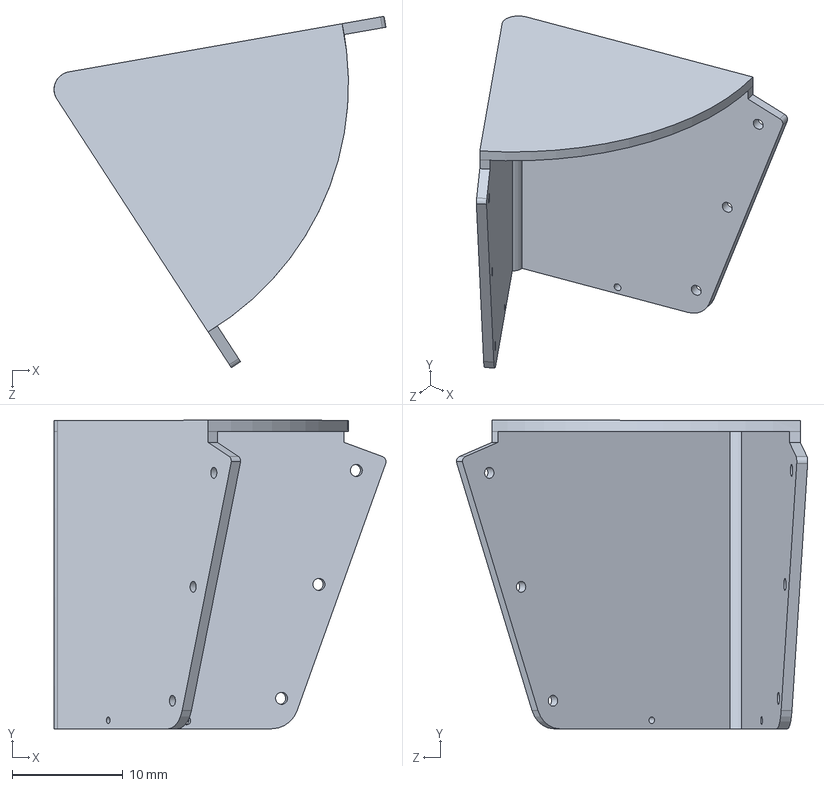
[picture p15: CAD file, 2022-04-26]
CoverV3.SLDPRT
30.0 x 27.9 x 31.7 mm
