VH-Lab/Microdrive-Array/Gianna/rat_drive_shuttle_short_GE_copy.SLDPRT

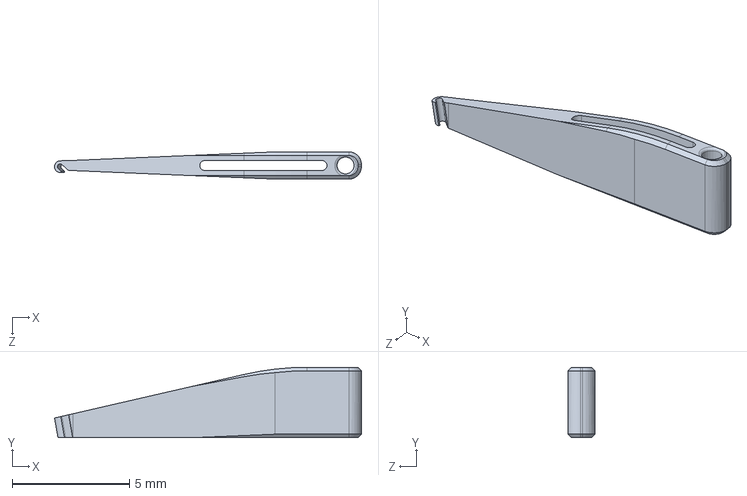
[picture p16: CAD file, 2022-03-24]
Gianna/rat_drive_shuttle_short_GE_copy.SLDPRT
13.1 x 3.00 x 1.16 mm
