VH-Lab/Microdrive-Array/SpikeGadgets_OpenEphys_Drive-main/SG_Drive_Jig_Assembly/Drive/drive_shuttle_JB_pallet-grey-v2.SLDPRT

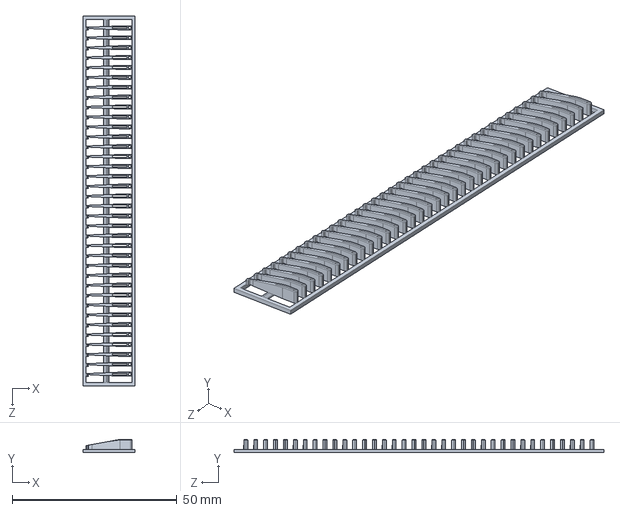
[picture p17: CAD file, 2022-03-24]
SpikeGadgets_OpenEphys_Drive-main/SG_Drive_Jig_Assembly/Drive/drive_shuttle_JB_pallet-grey-v2.SLDPRT
15.8 x 4.00 x 112.2 mm
