VH-Lab/Microdrive-Array/SpikeGadgets_OpenEphys_Drive-main/SG_Drive_Jig_Assembly/Guides/drive-guide-HPC-PFC_v2.1.SLDPRT

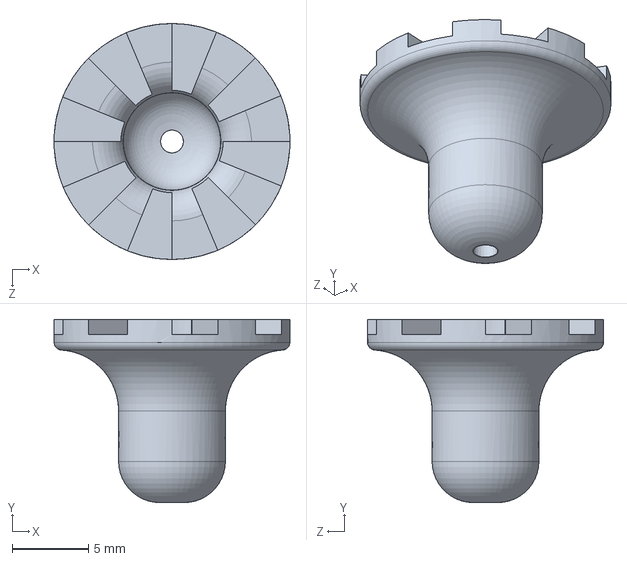
[picture p18: CAD file, 2022-03-24]
SpikeGadgets_OpenEphys_Drive-main/SG_Drive_Jig_Assembly/Guides/drive-guide-HPC-PFC_v2.1.SLDPRT
15.5 x 12.0 x 15.5 mm
