VH-Lab/Microdrive-Array/SpikeGadgets_OpenEphys_Drive-main/SG_Drive_Jig_Assembly/Jig/2020_12_14_stls/M2_Hex_Knob.STL

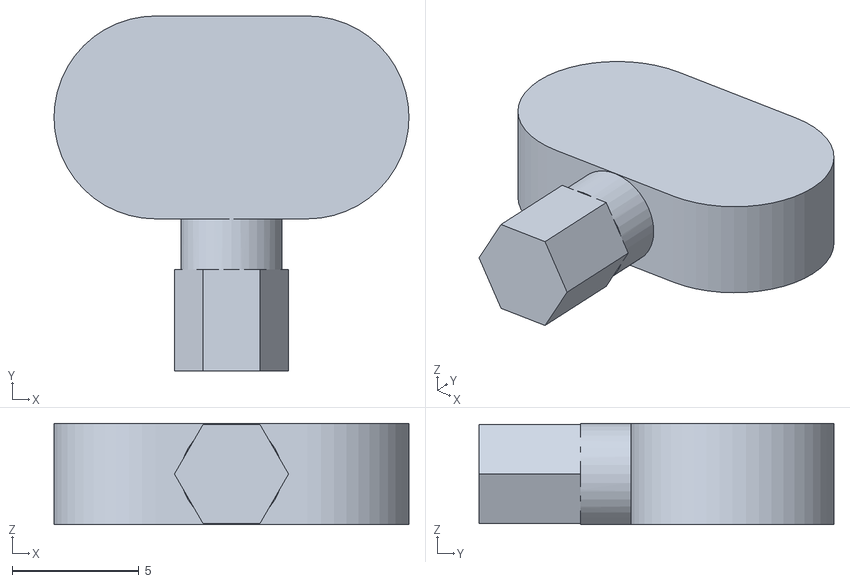
[picture p19: CAD file, 2022-03-24]
SpikeGadgets_OpenEphys_Drive-main/SG_Drive_Jig_Assembly/Jig/2020_12_14_stls/M2_Hex_Knob.STL
14.0 x 14.0 x 4.00
