VH-Lab/Microdrive-Array/Carbon Fiber Drive V3.SLDPRT

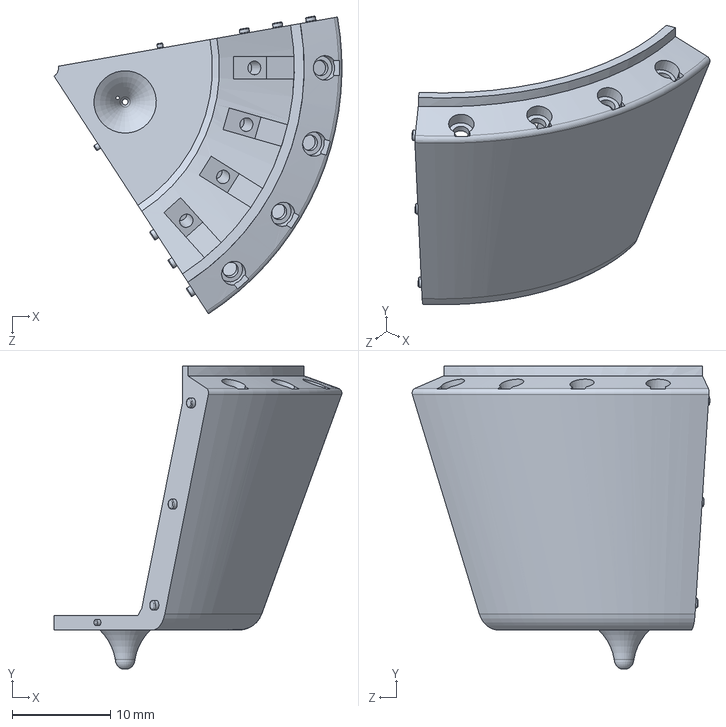
[picture p20: CAD file, 2022-04-26]
Carbon Fiber Drive V3.SLDPRT
29.3 x 30.8 x 30.3 mm
