VH-Lab/Microdrive-Array/Gianna/Shuttle V3_1.SLDPRT

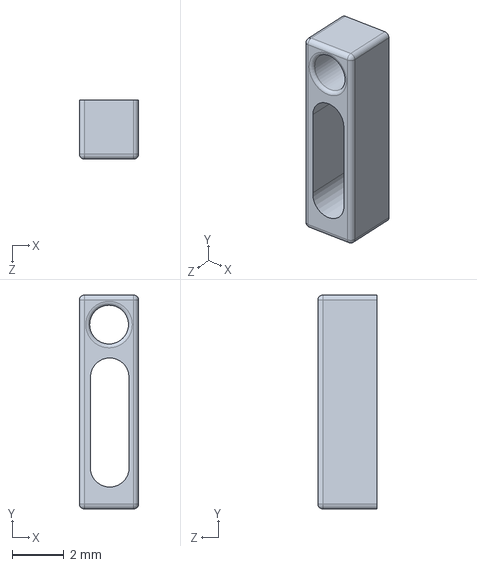
[picture p21: CAD file, 2022-03-24]
Gianna/Shuttle V3_1.SLDPRT
2.30 x 8.28 x 2.30 mm
