VH-Lab/Microdrive-Array/Realize Shuttle Print/Shuttle V3.SLDPRT

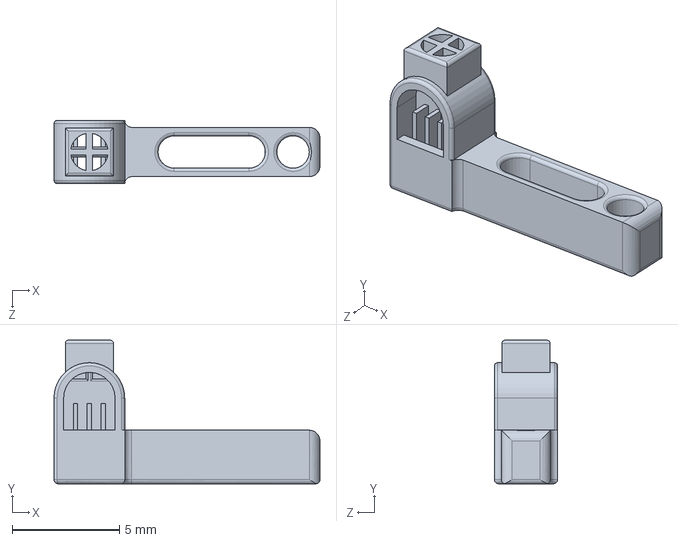
[picture p22: CAD file, 2022-03-24]
Realize Shuttle Print/Shuttle V3.SLDPRT
12.4 x 6.70 x 2.95 mm
