VH-Lab/Microdrive-Array/SpikeGadgets_OpenEphys_Drive-main/SG_Drive_Jig_Assembly/Jig/2020_12_14_stls/EIB_Holder_bottom.STL

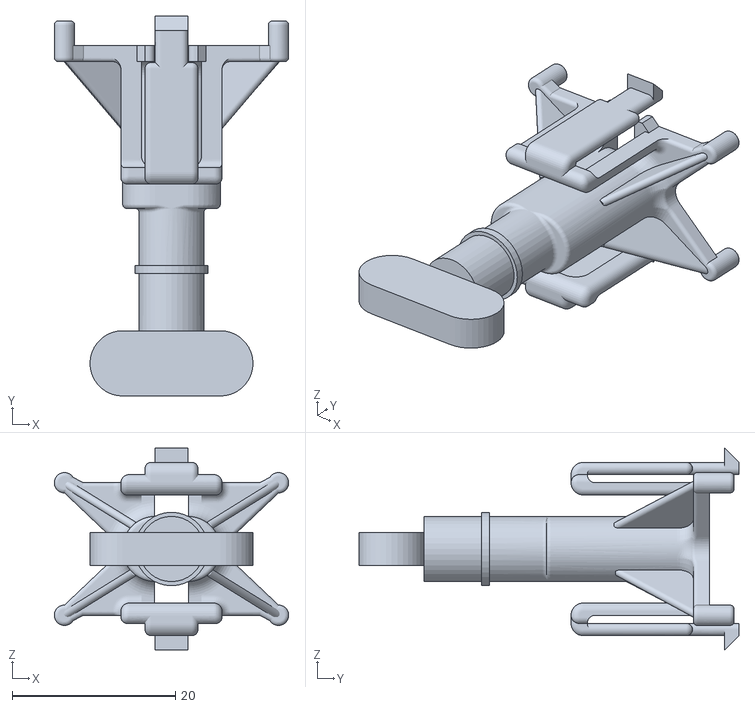
[picture p23: CAD file, 2022-03-24]
SpikeGadgets_OpenEphys_Drive-main/SG_Drive_Jig_Assembly/Jig/2020_12_14_stls/EIB_Holder_bottom.STL
28.8 x 46.6 x 24.8
