VH-Lab/Microdrive-Array/SpikeGadgets_OpenEphys_Drive-main/SG_Drive_Jig_Assembly/Jig/2020_12_14_stls/drive_holder_inner.STL

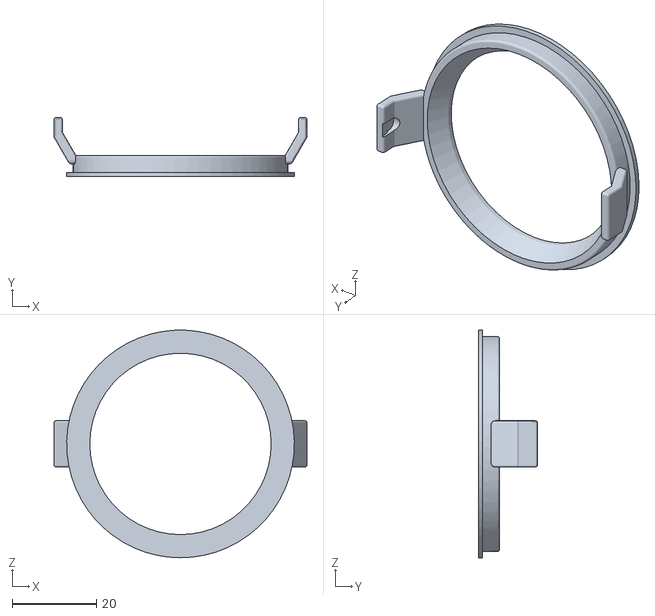
[picture p24: CAD file, 2022-03-24]
SpikeGadgets_OpenEphys_Drive-main/SG_Drive_Jig_Assembly/Jig/2020_12_14_stls/drive_holder_inner.STL
60.0 x 14.0 x 54.0
