VH-Lab/Microdrive-Array/SpikeGadgets_OpenEphys_Drive-main/SG_Drive_Jig_Assembly/Jig/2020_12_14_stls/drive_holder_outer_ring.STL

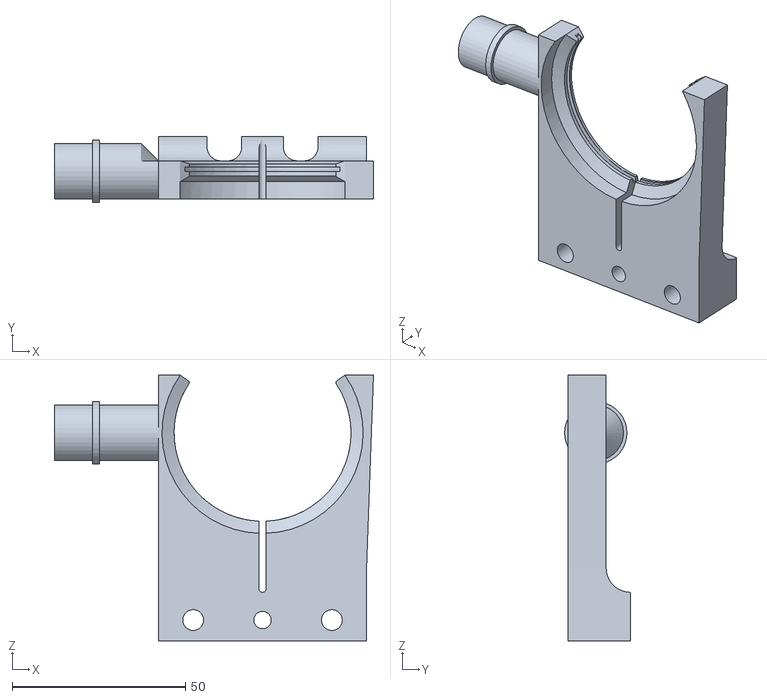
[picture p25: CAD file, 2022-03-24]
SpikeGadgets_OpenEphys_Drive-main/SG_Drive_Jig_Assembly/Jig/2020_12_14_stls/drive_holder_outer_ring.STL
92.0 x 19.0 x 76.6
