VH-Lab/Microdrive-Array/EIB Holder.SLDPRT

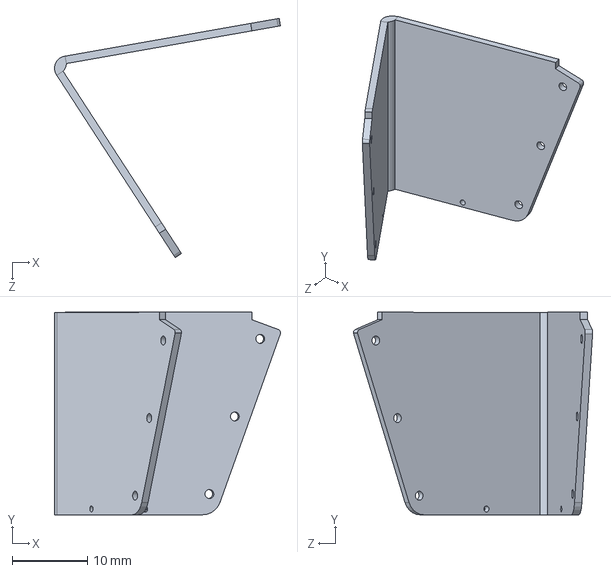
[picture p26: CAD file, 2022-04-25]
EIB Holder.SLDPRT
30.0 x 26.9 x 31.7 mm
