VH-Lab/Microdrive-Array/Drive_shuttle_pallet.SLDPRT

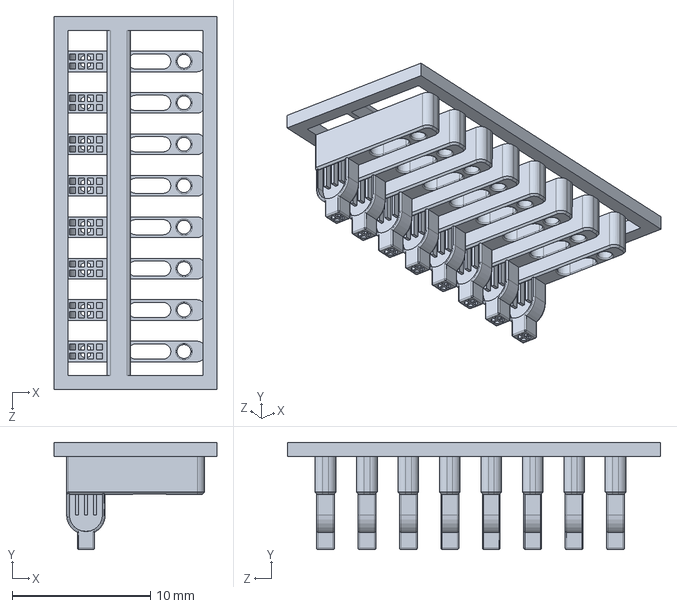
[picture p28: CAD file, 2022-03-24]
Drive_shuttle_pallet.SLDPRT
11.8 x 7.75 x 27.0 mm
