VH-Lab/Microdrive-Array/drive-guide-HPC-PFC_v2.1.SLDPRT

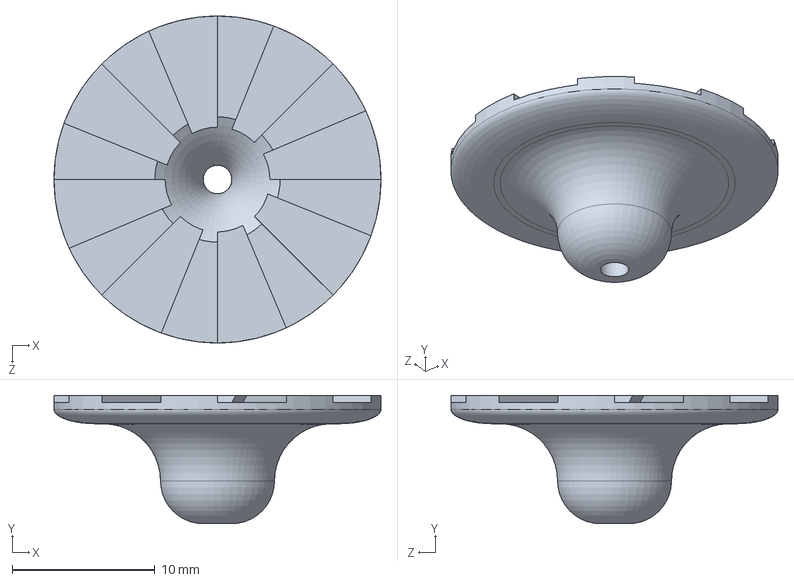
[picture p29: CAD file, 2022-03-24]
drive-guide-HPC-PFC_v2.1.SLDPRT
22.9 x 9.00 x 22.9 mm
