VH-Lab/Microdrive-Array/Realize Shuttle Print/JIgV3Print.STL

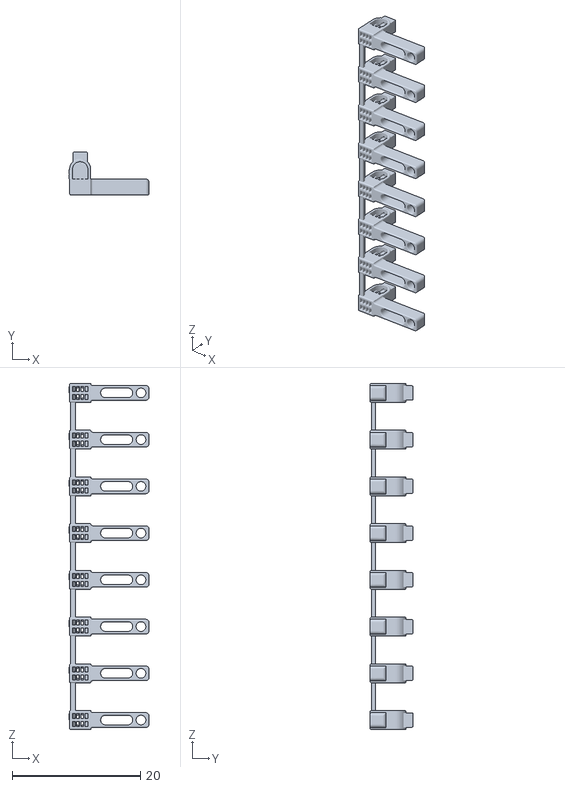
[picture p30: CAD file, 2022-03-24]
Realize Shuttle Print/JIgV3Print.STL
12.5 x 6.70 x 54.1
