VH-Lab/Microdrive-Array/Shuttle V3.SLDPRT

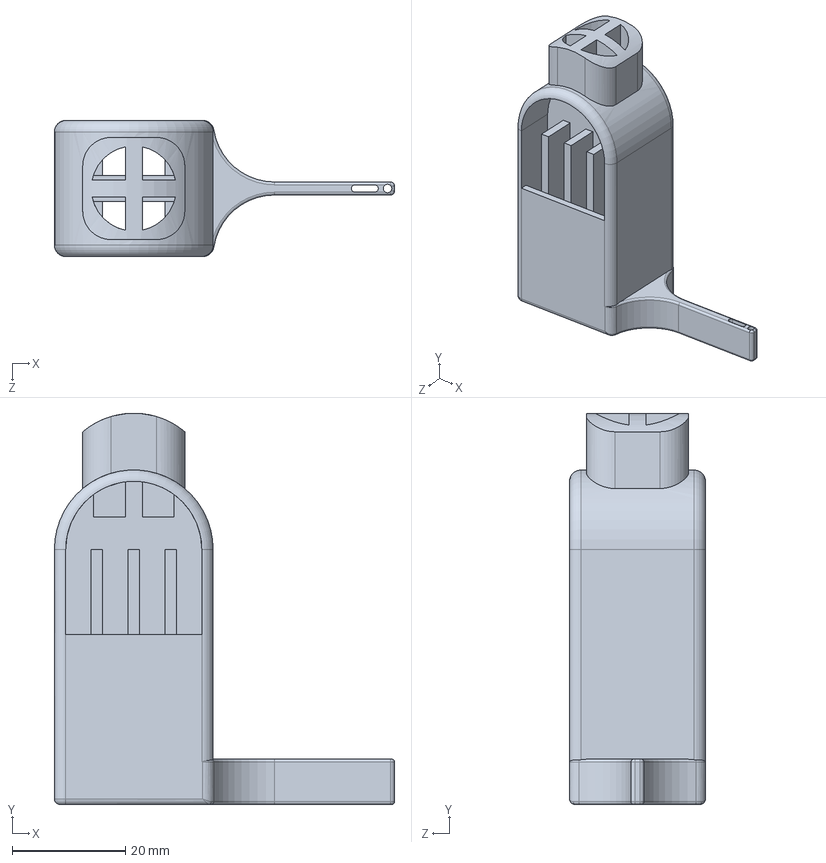
[picture p31: CAD file, 2022-03-24]
Shuttle V3.SLDPRT
60.0 x 68.9 x 24.0 mm
