VH-Lab/Microdrive-Array/Carbon Fiber Drive V1 Small.SLDPRT

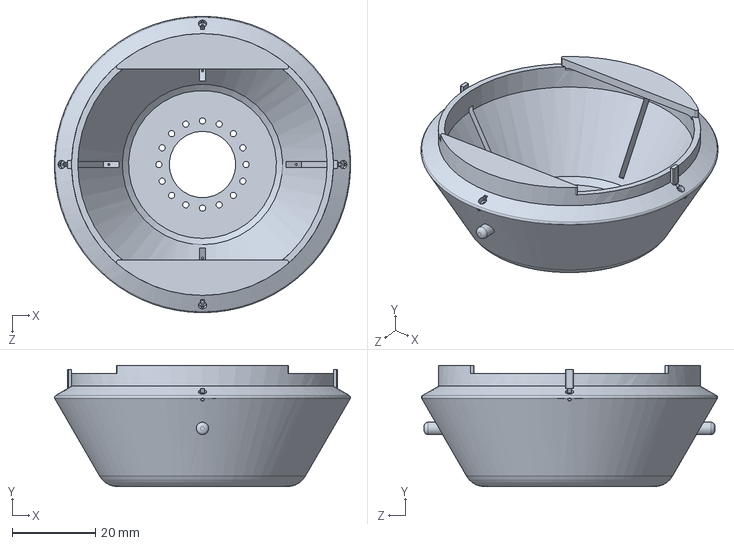
[picture p32: CAD file, 2022-03-24]
Carbon Fiber Drive V1 Small.SLDPRT
71.2 x 29.2 x 71.3 mm
