VH-Lab/Microdrive-Array/rat_drive_shuttle_long_Hook_JB_V2.SLDPRT

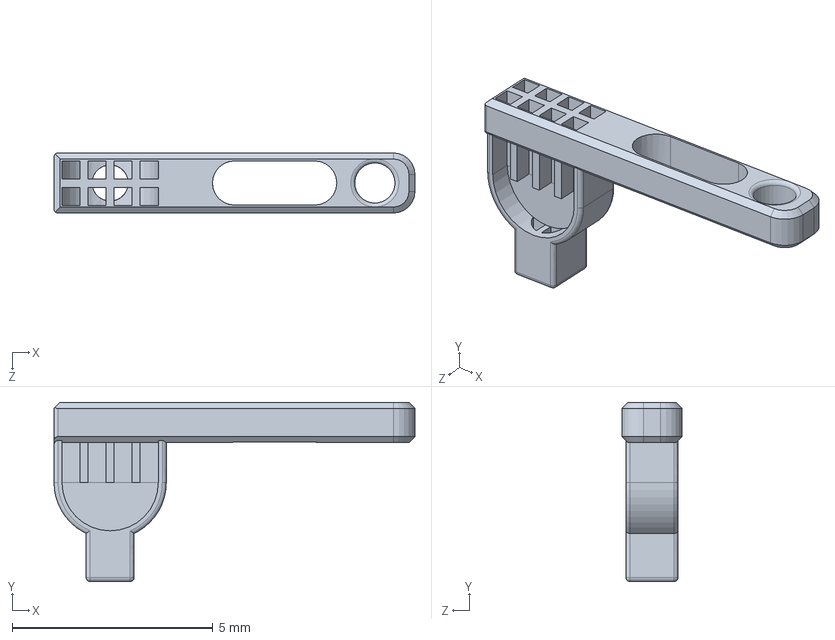
[picture p33: CAD file, 2022-03-24]
rat_drive_shuttle_long_Hook_JB_V2.SLDPRT
9.00 x 4.46 x 1.50 mm
