VH-Lab/Microdrive-Array/Drive_shuttle_jig.SLDPRT

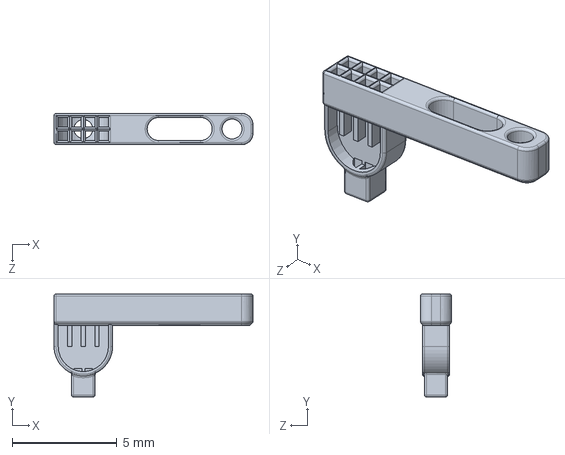
[picture p34: CAD file, 2022-03-24]
Drive_shuttle_jig.SLDPRT
9.50 x 4.92 x 1.50 mm
