VH-Lab/Microdrive-Array/drive_holder_outer_ring.SLDPRT

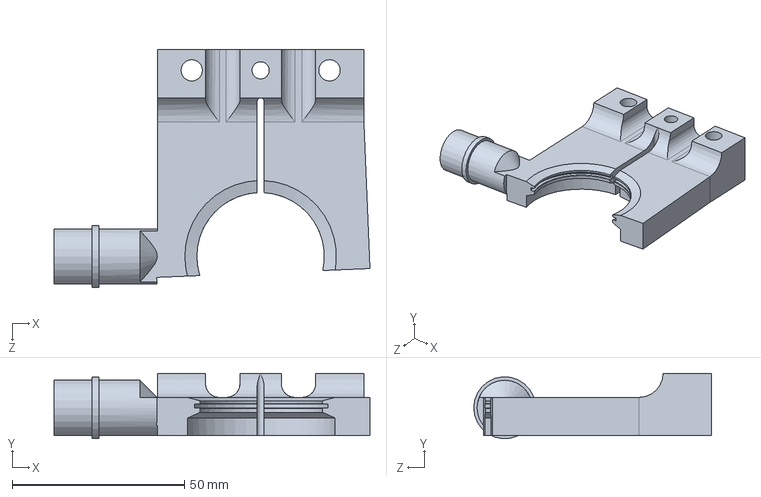
[picture p35: CAD file, 2022-03-24]
drive_holder_outer_ring.SLDPRT
91.8 x 19.0 x 69.0 mm
