VH-Lab/Microdrive-Array/(list of files, cad)

Other CAD files:
Realize Shuttle Print/Shuttle V3 .754.SLDPRT
Realize Shuttle Print/Shuttle V3 .762.SLDPRT
Realize Shuttle Print/Shuttle V3 .752.SLDPRT
Shuttle V3 .748.SLDPRT
Part1.SLDPRT
Realize Shuttle Print/Shuttle V3 .748.SLDPRT
Realize Shuttle Print/Shuttle V3 .760.SLDPRT
Realize Shuttle Print/Shuttle V3 .756.SLDPRT
Realize Shuttle Print/Shuttle V3 .750.SLDPRT
Realize Shuttle Print/Shuttle V3 .758.SLDPRT
Part3.SLDPRT
EIB_Holder_bottom.SLDPRT
eib_holder_top.SLDPRT
base.SLDPRT
drive_holder_inner.SLDPRT
Assembly v2.SLDASM
Carbon Fiber Drive V1.SLDPRT
Carbon Fiber Drive V1.STL
Carbon Fiber Drive V2.SLDPRT
Carbon Fiber Drive V2.STL
Carbon Fiber Drive V3 - Copy.SLDPRT
Drive_shuttle_jig - Copy.SLDPRT
Drive_shuttle_pallet.STL
Shuttle v3 print2.STL
Slanted-threaded-sholder screw.SLDPRT
SpikeGadgets_OpenEphys_Drive-main/SG_Drive_Jig_Assembly/Drive/Old Drive and shuttle versions/drive_body_v3.SLDPRT
SpikeGadgets_OpenEphys_Drive-main/SG_Drive_Jig_Assembly/Drive/Old Drive and shuttle versions/drive_shuttle_JB_pallet-grey.SLDPRT
SpikeGadgets_OpenEphys_Drive-main/SG_Drive_Jig_Assembly/Drive/Old Drive and shuttle versions/rat_drive_shuttle_JB_pallet.SLDPRT
SpikeGadgets_OpenEphys_Drive-main/SG_Drive_Jig_Assembly/Guides/drive-guide-HPC-PFC_v2.SLDPRT
base.STL
drive-guide-HPC-PFC_v2.1.STL
drive_holder_inner.STL
drive_holder_outer_ring.STL
